marx-merten/zmk-macropad/3d/macropad_case_design.step

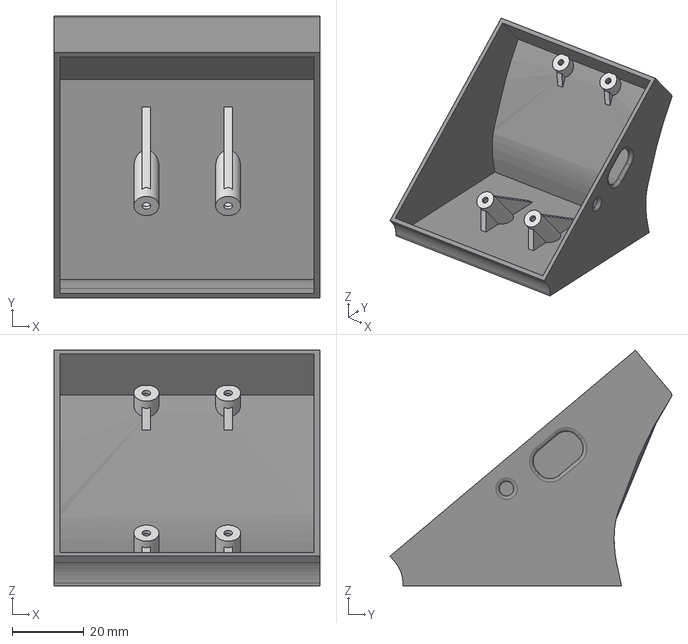
[picture p1: CAD file, 2024-03-30]
3d/macropad_case_design.step
74.2 x 78.7 x 65.8 mm
