marx-merten/zmk-macropad/(list of files, cad)

Other CAD files:
3d/macropad_case.stl
