marx-merten/zmk-macropad/pcb/dongle.kicad_pcb

## KiCad design pcb/dongle.kicad_pcb (2024-03-30)

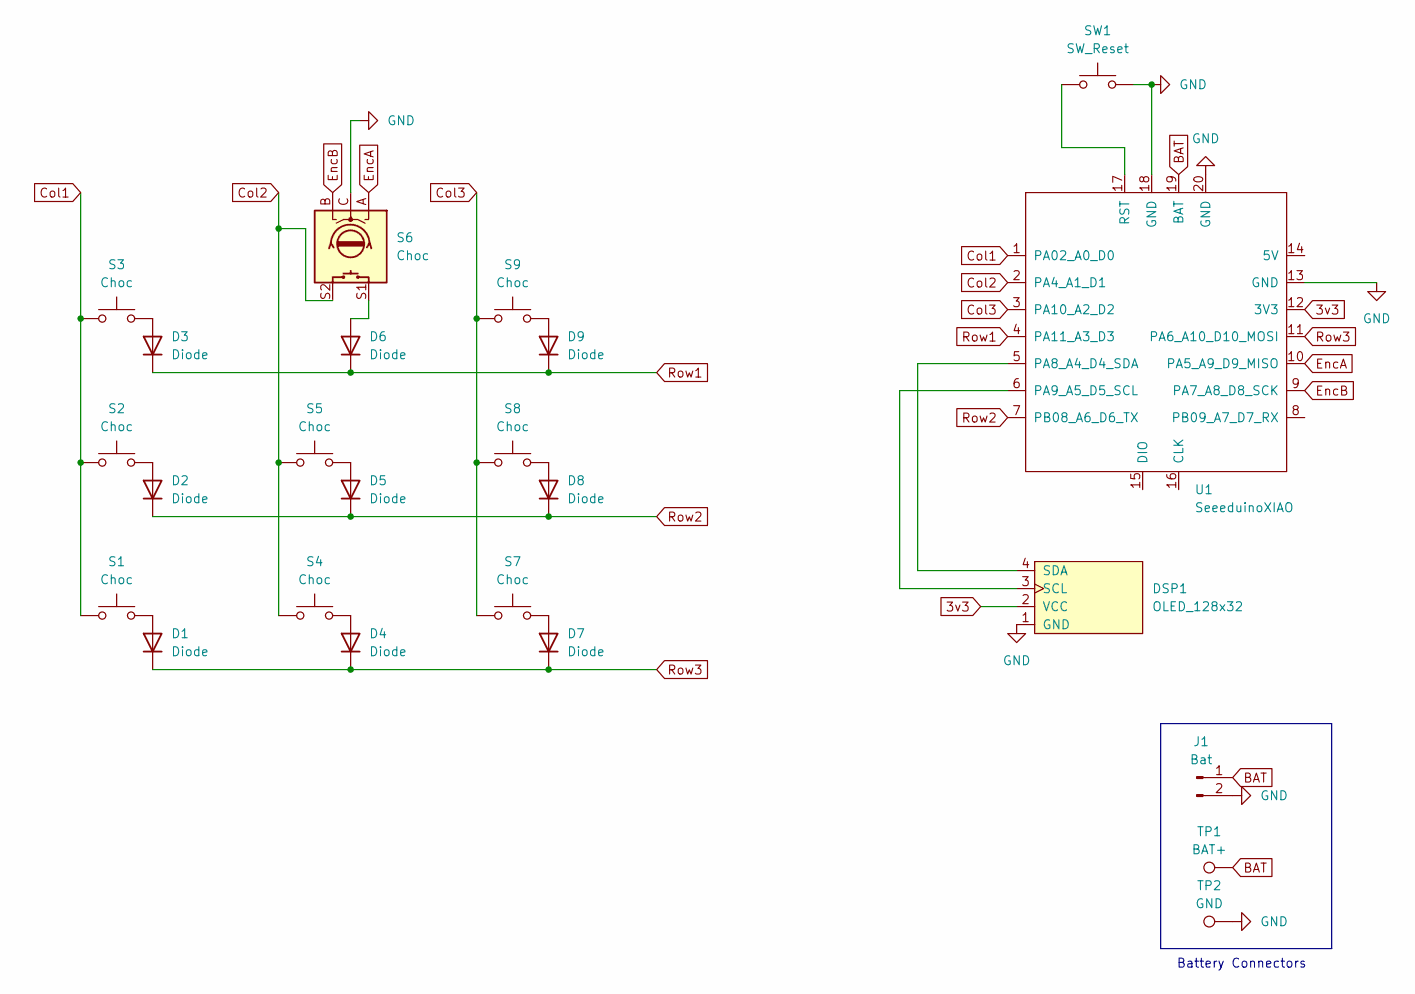
[picture p2: schematic dongle.kicad_sch]

Parts:
D1, D2, D3, D4, D5, D6, D7, D8, D9: Diode; D_SOD-123; MPN C493190; LCSC PartNumber C493190
DSP1: OLED_128x32
J1: Bat; JST_PH_S2B-PH-K_1x02_P2.00mm_Horizontal
S1, S2, S3, S4, S5, S7, S8, S9: Choc; Kailh_socket_PG1350; MPN C5333465; LCSC PartNumber C5333465
S6: Choc; RotaryEncoder_Alps_EC11E-Switch_Vertical_H20mm; Digi-Key_PN PEC11R-4215F-S0024-ND
SW1: SW_Reset; SW_SPST_EVQP7A; Part number Panasonic EVQ-P7A01P; LCSC PartNumber C2917474
TP1: BAT+; TestPoint_Pad_1.5x1.5mm
TP2: GND; TestPoint_Pad_1.5x1.5mm
U1: SeeeduinoXIAO; xiao-ble-smd-cutout

Connections:
3v3: DSP1.2 (VCC), U1.12 (3V3)
BAT: J1.1, TP1.1, U1.19 (BAT)
Col1: S1.1, S2.1, S3.1, U1.1 (PA02_A0_D0)
Col2: S4.1, S5.1, S6.S2, U1.2 (PA4_A1_D1)
Col3: S7.1, S8.1, S9.1, U1.3 (PA10_A2_D2)
EncA: S6.A, U1.10 (PA5_A9_D9_MISO)
EncB: S6.B, U1.9 (PA7_A8_D8_SCK)
GND: DSP1.1 (GND), J1.2, S6.C, SW1.2, TP2.1, U1.13 (GND), U1.18 (GND), U1.20 (GND)
unnamed: D1.2 (A), S1.2
unnamed: D2.2 (A), S2.2
unnamed: D3.2 (A), S3.2
unnamed: D4.2 (A), S4.2
unnamed: D5.2 (A), S5.2
unnamed: D6.2 (A), S6.S1
unnamed: D7.2 (A), S7.2
unnamed: D8.2 (A), S8.2
unnamed: D9.2 (A), S9.2
unnamed: DSP1.3 (SCL), U1.6 (PA9_A5_D5_SCL)
unnamed: DSP1.4 (SDA), U1.5 (PA8_A4_D4_SDA)
unnamed: SW1.1, U1.17 (RST)
Row1: D3.1 (K), D6.1 (K), D9.1 (K), U1.4 (PA11_A3_D3)
Row2: D2.1 (K), D5.1 (K), D8.1 (K), U1.7 (PB08_A6_D6_TX)
Row3: D1.1 (K), D4.1 (K), D7.1 (K), U1.11 (PA6_A10_D10_MOSI)

Notes on the sheet:
Battery Connectors

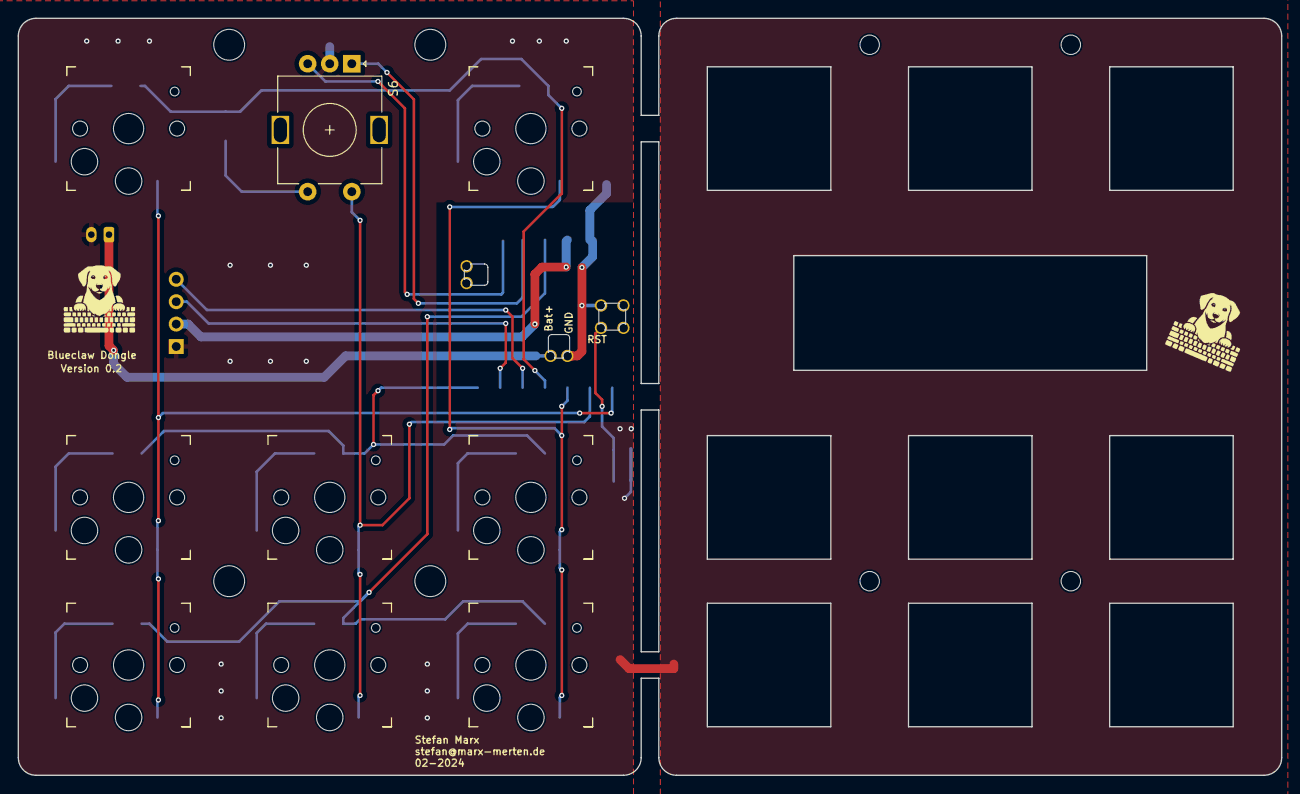
[picture p3: board dongle.kicad_pcb from above]

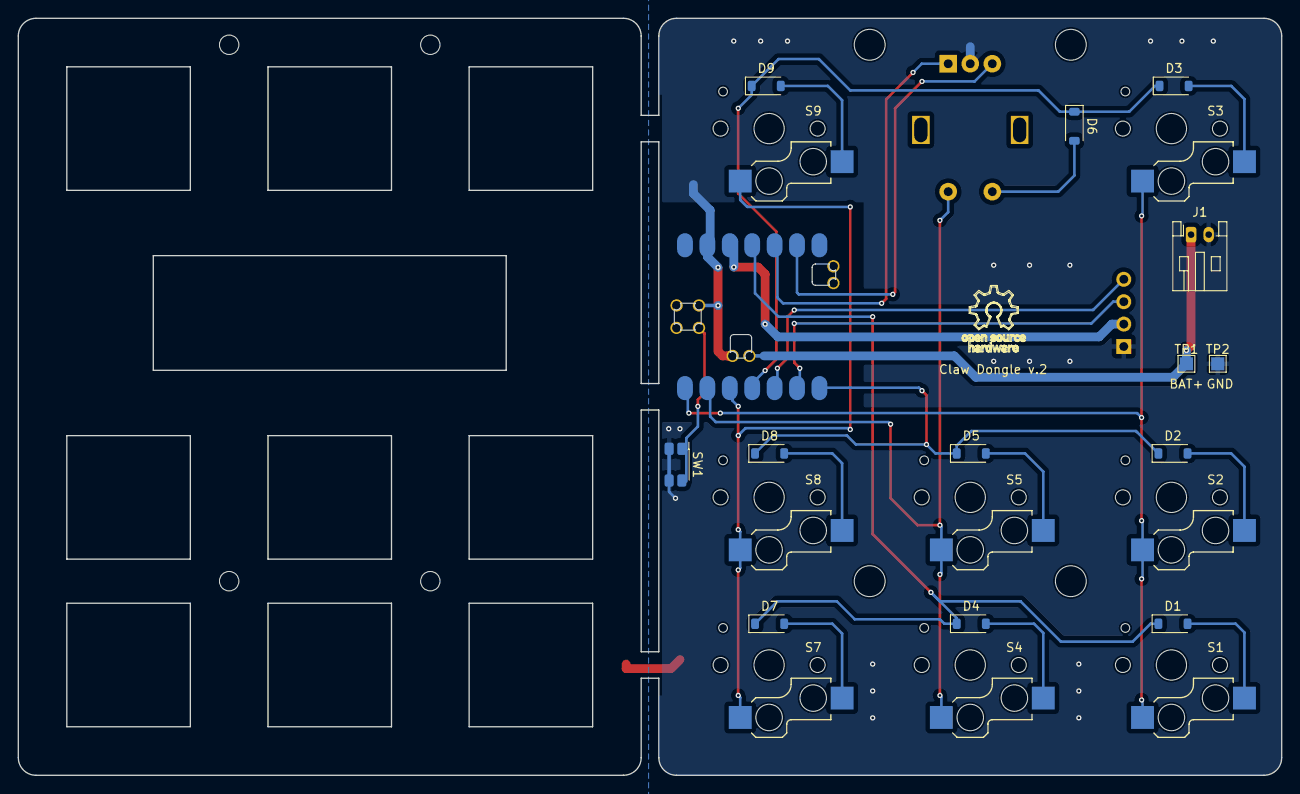
[picture p4: board dongle.kicad_pcb from below]

Board: 2 copper layers, 143.2 x 85.8 mm, 35 parts (15 on the bottom side), 23 nets.

Other parts of the board:
GL1, GL2: LOGO; DDKeyboard_10_10
Logo: Claw Dongle v.2; OSSLogo
M1, M2, M3, M4: MOUNT; MountingHole_3.5mm
M5, M6, M7, M8: MOUNT; MountingHole_2.2mm_M2_DIN965
