marx-merten/zmk-macropad/(commit log)

2024-03-04 tuned encoder settings
2024-03-30 added PCB
    [bom.csv, designators.csv, dongle.kicad_pcb, dongle.kicad_sch, positions.csv]
2024-03-30 added 3d designs
    [macropad_case.stl, macropad_case_design.step]
